DaveScott800/Binary-Clock/Bin Clk Sch_PCB_Combo.JPG

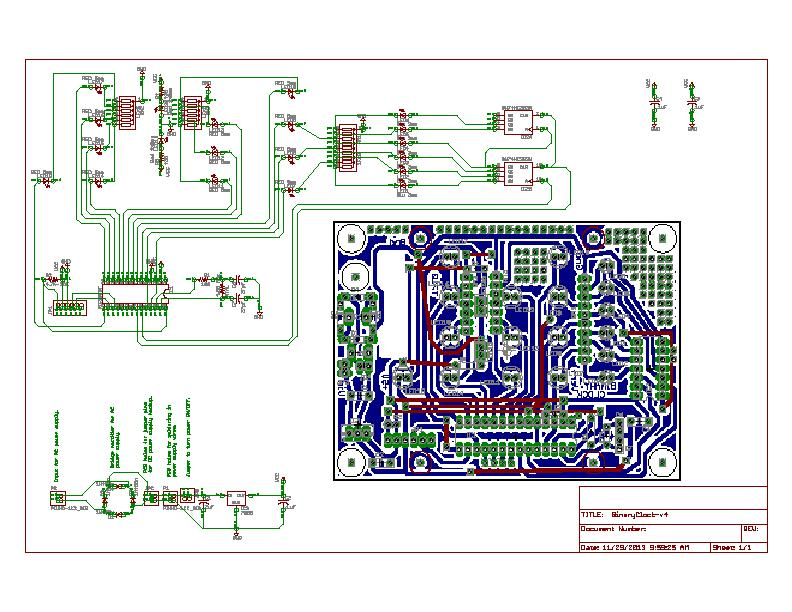
Bin Clk Sch_PCB_Combo.JPG
