DaveScott800/Binary-Clock/README.md

# Binary-Clock
A project for Electronics merit badge to build a binary clock.  The hours and minutes are binary coded decimal.  The seconds are ordinary binary (6 leds).  The seconds LEDs only count up once every 5 minutes.
The circuit uses a PIC16F57 and a SN74HC393N.
