DaveScott800/Binary-Clock/Parts List BOM.xls

PARTS LIST
Part | Qty | Part Number | Description | Identification
C1 | 1 | 493-1057-ND | CAP ALUM 10UF 25V 20% RADIAL | 10uF 25V
C2-C4 | 3 | 490-5401-ND | CAP CER 0.1UF 50V RADIAL | 104Z
C6&C7 | 2 | 445-4719-ND | CAP 27PF CERAMIC 5% COG NPO 50V | 27
IC1 | 1 | PIC16F57-I/SP-ND | IC MCU 8BIT 3KB FLASH 28SDIP | PIC16F57 (Static sensitive - avoid extra handling!)
IC2 | 1 | 296-8319-5-ND | IC DUAL 4-BIT BIN CNTR 14-DIP | SN74HC393N (Static sensitive - avoid extra handling!)
LED19 & 20 | 2 | 754-1201-ND | LED RECT 2X5MM 625NM RED DIFF | Red rectangular LEDs
LED1-LED6 | 6 | 754-1603-ND | LED GREEN DIFF 3MM 568NM | Green 3mm LEDs (Static sensitive - avoid extra handling!)
LED7-LED18 | 12 | 754-1264-ND | LED SS 5MM 625NM RED DIFF | Red 5mm round LEDs
R1,R3 | 1 | 100QBK-ND | RES 100 OHM 1/4W 5% AXIAL | Resistor (brown-black-brown).
R2 | 1 | 5.1KQBK-ND | RES 5.1KOHM 1/4W 5% AXIAL | Resistor (green-brown-red).
R4 & R5 | 2 | 430EBK-ND | RES 430 OHM 1/6W 5% AXIAL | Resistor (yellow-orange-brown).
RN1 | 1 | 4610X-1-102LF-ND | RES ARRAY 1K OHM 9 RES 10SIP | 10X-1-102LF
RN2&RN3 | 2 | 4606X-1-102LF-ND | RES ARRAY 1K OHM 5 RES 6SIP | 6X-1-102LF
XTAL | 1 | CTX896-ND | CRYSTAL 4MHZ 18PF THRU | ATS040B (Physically sensitive - avoid extra handling!)
 | 1 | ED3050-5-ND | CONN IC SOCKET VERT 28POS TIN | 28 pin IC socket.
 | 1 | ED3045-5-ND | CONN IC SOCKET VERT 14POS TIN | 14 pin IC socket.
 | 1 | SR032-CB-ND | BOX 4.38X3.25X1.40 BLACK | Plastic Box.
JP1, JP3 | 8 | S1012EC-36-ND | CONN HEADER .100 SNGL STR 36POS | In Bug Box #6. Cut off a 2-fer and a 6-fer with diagonal cutters.
 | 1 |  | PCB | Binary Clock ver 4
 | 1 |  | Jumper for 2 pins, small black square. | In Bug Box #6.
 | 4 |  | #4 X 1/2" sheet metal screws | In Bug Box #6.
 | 4 |  | Spacers, 0.3" or 5/16" cut from tubing. | See step 14.1.
The Part Numbers are Digikey numbers.
If you mail a check with your written order, Digikey charges nothing for shipping and handling!
So, you can order your parts for the costs of the parts alone plus sales tax!
Note - I've used the part listed above for LED19 & LED20. But in the finished project, they don't show up as visually different from the LED7-18.
This work is licensed for any non-commercial use under the Creative Commons Attribution-NonCommercial-ShareAlike 4.0 International License.
To view a copy of this license, visit http://creativecommons.org/licenses/by-sa/4.0/ or send a letter to Creative Commons, PO Box 1866, Mountain View, CA 94042, USA.
x
