DaveScott800/Binary-Clock/LED Calculations.xls

 |  |  |  | Notes |  |  |  |  |  |  |  |  | Prices
Source | Date | Part# | Desc. | mcd | Vf | ma | Angles | Lens Type |  | R |  |  | ea@1 | ea@10 | ea@25 | ea@50 | ea@100
Digikey | 2013-07-17 | 754-1596 | LED Blue Clear 3mm 470nm | 2000 | 3.3 | 20 | 20 | Clear |  | 1000 | 0.0017 | 2ma OK
Digikey | 2013-09-01 | 754-1603 | LED Green Diff 3mm 568nm | 30 | 2.2 | 10 | 40 | Diffused, Tinted |  | 1000 | 0.0028 | 3-5 ma OK
Digikey | 2013-09-01 | 1080-1012-1 | LED Oval Blue Diff 1A 110X50 | 1085 | 3.2 | 20 | 110,50 | Diffused, Tinted |  | 1000 | 0.0018
Digikey | 2013-09-01 | 365-1173 | LED Blue Round 3mm 470nm | 900 | 3.4 | 20 | 45 | Round, clear |  | 800 | 0.002 | 2 ma ok
Digikey | 2013-09-01 | 754-1264 | LED Red SS 5mm Diff 625nm | 45 | 2 | 10 | 30 | Diffused, Tinted |  | 1000 | 0.003 | 3-5 ma is OK.
Digikey | 2013-07-17 | 754-1201 | LED Red Diff Rect 2X5mm 625nm | 5 | 2 | 10 | 110 | Diffused, Tinted |  | 425 | 0.007058823529 | looks weak below 7 ma
Other LEDs: (11/22/15) |  |  |  |  |  |  |  |  |  | R (Short calc)
Mouser |  | 859-LTL-10223W | Red 5mm 625nm |  |  |  |  |  |  |  |  |  |  | 0.069 |  | 0.061 | 0.055
Mouser |  | 859-LTL-4253 | Yellow 5mm | 19 |  |  |  |  |  | 456 |  |  |  |  |  | 0.061 | 0.055
Mouser |  | 859-LTL-307A | Amber 5mm | 29 |  |  |  |  |  | 696 |  |  |  |  | 0.069 | 0.061 | 0.055
Mouser |  | 859-LTL-4233 | Green 5mm | 19 |  |  |  |  |  | 456 |  |  |  |  | 0.069 | 0.061 | 0.055
Mouser |  | 696-SSL-LX3054GW | Greem 3mm 565nm | 30 |  |  |  |  |  | 720 |  |  | 0.13 |  |  |  | 0.117
Mouser |  | 604-WP132XID | Red 3mm 625nm | 25 |  |  |  |  |  | 600 |  |  |  | 0.092 |  |  | 0.068
Mouser |  | 604-WP132XYD | Yellow 3mm | 25 |  |  |  |  |  | 600 |  |  |  | 0.092 |  |  | 0.068
Mouser |  | 859-LTL-1CHA | Amber 3mm 602nm | 12.6 |  | Same nm as preferred from Digikey |  |  |  | 302.4 |  |  | 0.1 | 0.069 |  | 0.061 | 0.055
Mouser |  | 859-LTL-1CHAE | Amber 3mm 605nm | 29 |  | Might be ok also as dominant nm matches. |  |  |  | 696 |  |  | 0.1 | 0.069 |  | 0.061 | 0.055
 |  | 2015-11-21
 |  |  |  | Vf | Vsup | R | I | MCDnom | MCDact | Short Calc |  | Short Calc = R to get 12.5mcd approximation.
 |  | 754-1603 | Grn 3mm | 1.85 | 5 | 1000 | 3.15 | 25 | 7.9 | 600
 |  |  | Typ 25 mcd @ 10ma and is linear with current (more or less for all these LEDs that I checked). |  |  |  |  |  |  |  |  | MCD nom | Use R
 |  |  | Vf = 2.2 @ 20ma |  |  |  |  |  |  |  |  | 7 | 430
 |  |  | Vf = 2.0 @ 10ma |  |  |  |  |  |  |  |  | 25 | 1000
 |  |  | Vf = 1.8 @ 2ma |  |  |  |  |  |  |  |  | 29 | 700
 |  | 754-1201 | Red 2X5 | 1.82 | 5 | 430 | 7.395348837 | 7 | 5.2 | 168 |  | 50 | 1000
 |  |  | Typ 7 mcd @ 10ma
 |  |  | Vf = 2.0 @ 20ma
 |  |  | Vf = 1.9 @ 10ma
 |  |  | Vf = 1.82 @ 6ma
 |  |  | Vf = 1.7 @ 2ma
 |  | 754-1264 | Red 5mm | 1.75 | 5 | 1000 | 3.25 | 50 | 16.2 | 1200
 |  |  | Typ 50 mcd @ 10ma
 |  |  | Vf = 2.0 @ 20ma
 |  |  | Vf = 1.9 @ 10ma
 |  |  | Vf = 1.82 @ 6ma
 |  |  | Vf = 1.7 @ 2ma
 |  | 160-1949 | Amber 5mm | 1.85 | 5 | 700 | 4.5 | 29 | 13.1 | 696 | With R=1000 is maybe OK, a bit marginal when viewed from an angle.
 |  |  | Typ 29 mcd @ 10ma | 1.75 | 5 | 1000 | 3.25 | 29 | 9.4 | 696
 |  |  | Vf = 2.1 @ 20ma
 |  |  | Vf = 1.85 @ 10ma
 |  |  | Vf = 1.72 @ 5ma
