DaveScott800/Binary-Clock/PCB Image v5.pdf

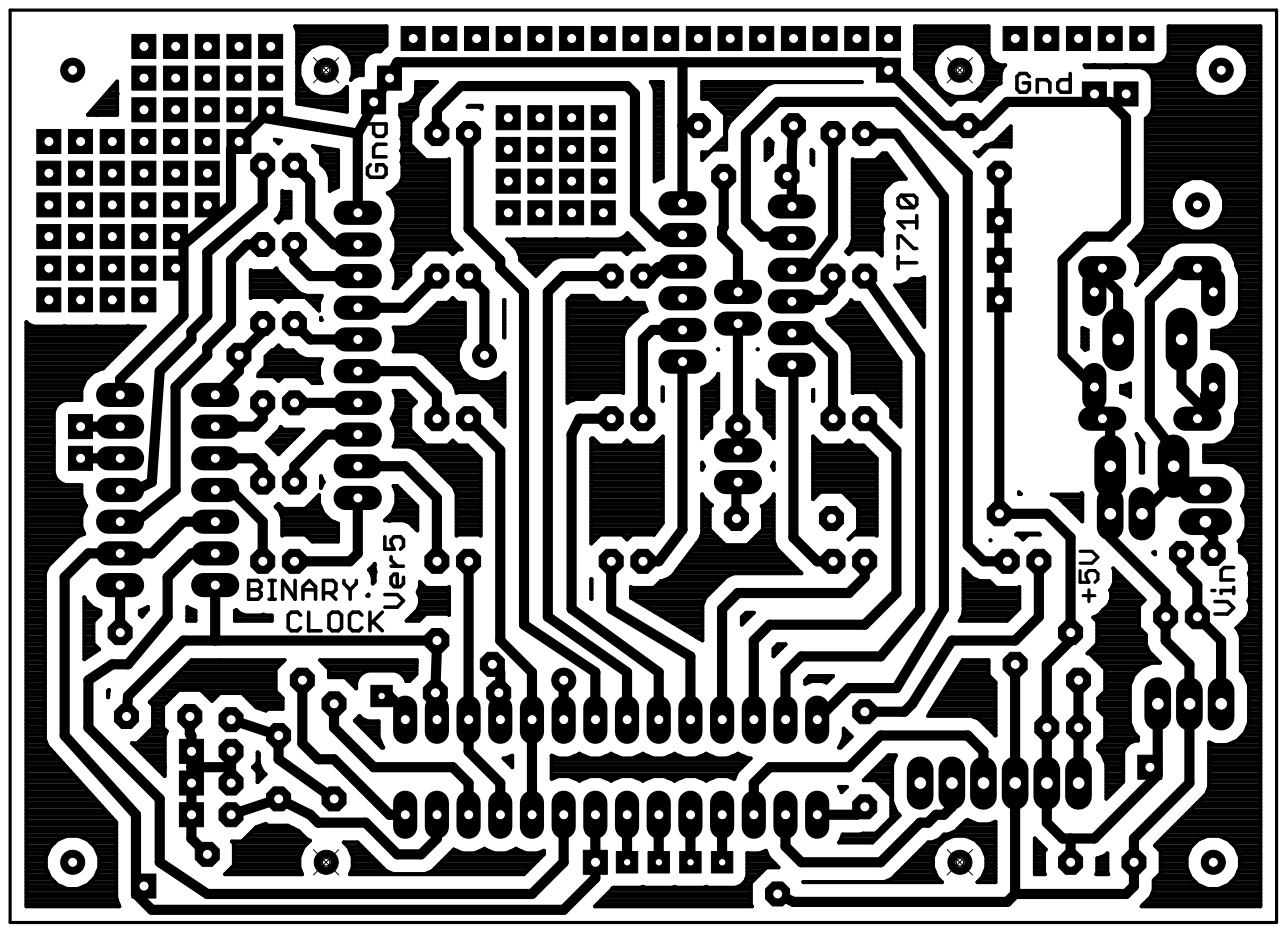
[picture p25: page 1]
