DaveScott800/Binary-Clock/BinaryClock-v5.brd

## EAGLE design BinaryClock-v5.brd (2016-07-04)

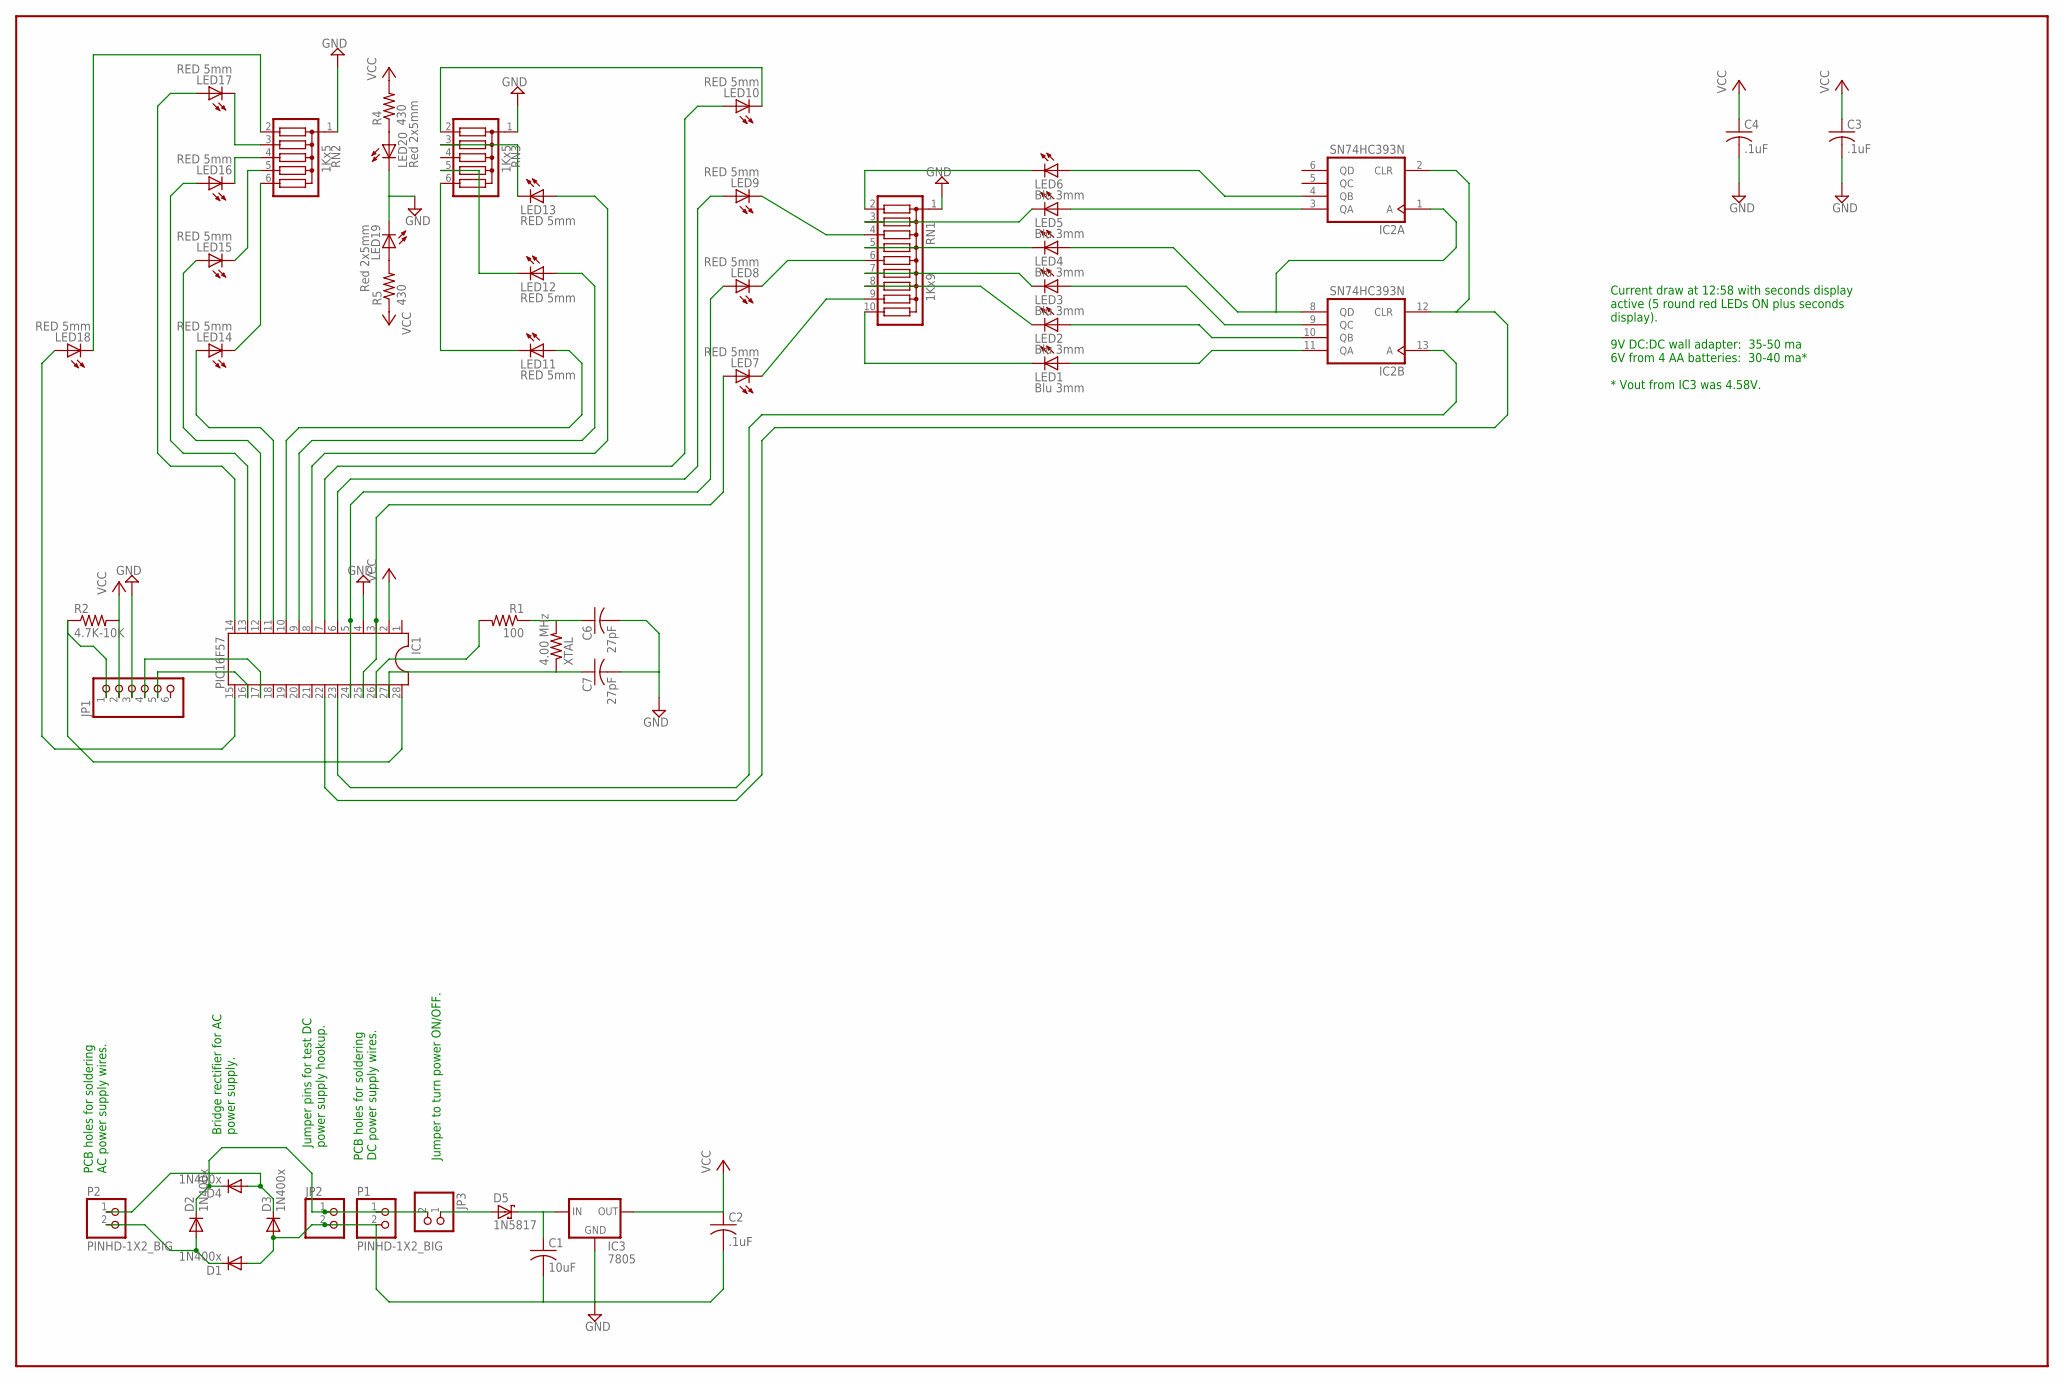
[picture p26: schematic BinaryClock-v5.sch]

Parts:
C1: 10uF; C025-050X050
C2, C3, C4: .1uF; C050-025X075
C6, C7: 27pF; C025-025X050
D1, D2, D3, D4: 1N400x; D-7.5
D5: 1N5817; 0207/2V
IC1: PIC16F57; DIL28-3
IC2: SN74HC393N; DIL14
IC3: 7805; 78MXXS
JP1: PINHD-1X6/90; 1X06/90
JP2, JP3: PINHD-1X2; 1X02
LED1, LED2, LED3, LED4, LED5, LED6: Blu 3mm; LED3MM
LED7, LED8, LED9, LED10, LED11, LED12, LED13, LED14, LED15, LED16, LED17, LED18: RED 5mm; LED5MM
LED19, LED20: Red 2x5mm; U57X32
P1, P2: PINHD-1X2_BIG; 1X02_BIG
R1: 100; 0207/7
R2: 4.7K-10K; 0207/2V
R4: 430; 0204/5
R5: 430; 0204/7
RN1: 1Kx9; SIL10
RN2, RN3: 1Kx5; SIL6
XTAL: 4.00 MHz; 0204/5

Connections:
GND: C1.2, C2.2, C3.2, C4.2, C6.2, C7.2, D1.A, D3.A, IC1.4, IC2.7 (GND), IC3.GND, JP1.3, JP2.2, LED19.K (C), LED20.K (C), P1.2, RN1.1, RN2.1, RN3.1
unnamed: IC2.3 (QA), LED5.A
unnamed: IC2.11 (QA), LED1.A
unnamed: IC2.10 (QB), LED2.A
unnamed: IC2.9 (QC), LED3.A
unnamed: IC2.1 (A), IC2.8 (QD), LED4.A
unnamed: C1.1, D5.2 (C), IC3.IN
unnamed: IC2.4 (QB), LED6.A
unnamed: IC1.22, IC2.2 (CLR), IC2.12 (CLR)
unnamed: C7.1, IC1.27, XTAL.1
unnamed: C6.1, R1.1, XTAL.2
unnamed: LED1.K (C), RN1.10
unnamed: IC1.26, R1.2
unnamed: LED7.K (C), RN1.9
unnamed: IC1.28, JP1.1, R2.1
unnamed: IC1.8, LED13.A
unnamed: IC1.16, JP1.5
unnamed: IC1.23, IC2.13 (A)
unnamed: IC1.3, IC1.25, LED7.A
unnamed: IC1.5, IC1.24, LED8.A
unnamed: IC1.6, LED9.A
unnamed: IC1.7, LED10.A
unnamed: IC1.9, LED12.A
unnamed: IC1.10, LED11.A
unnamed: IC1.11, LED14.A
unnamed: IC1.12, LED15.A
unnamed: IC1.13, LED16.A
unnamed: IC1.14, LED17.A
unnamed: IC1.17, JP1.4
unnamed: LED2.K (C), RN1.8
unnamed: LED4.K (C), RN1.5
unnamed: IC1.15, LED18.A
unnamed: LED9.K (C), RN1.4
unnamed: LED3.K (C), RN1.7
unnamed: LED8.K (C), RN1.6
unnamed: LED5.K (C), RN1.3
unnamed: LED6.K (C), RN1.2
unnamed: LED10.K (C), RN3.2
unnamed: LED13.K (C), RN3.3
unnamed: LED11.K (C), RN3.6
unnamed: LED12.K (C), RN3.5
unnamed: LED14.K (C), RN2.6
unnamed: LED15.K (C), RN2.5
unnamed: LED16.K (C), RN2.4
unnamed: LED17.K (C), RN2.3
unnamed: LED18.K (C), RN2.2
unnamed: D2.C, D4.C, JP2.1, JP3.2, P1.1
unnamed: LED20.A, R4.1
unnamed: LED19.A, R5.2
unnamed: D1.C, D2.A, P2.2
unnamed: D3.C, D4.A, P2.1
unnamed: D5.1 (A), JP3.1
VCC: C2.1, C3.1, C4.1, IC1.2, IC2.14 (VCC), IC3.OUT, JP1.2, R2.2, R4.2, R5.1

Notes on the sheet:
PCB holes for soldering AC power supply wires.
Bridge rectifier for AC power supply.
Jumper pins for test DC power supply hookup.
PCB holes for soldering DC power supply wires.
Jumper to turn power ON/OFF.
Current draw at 12:58 with seconds display active (5 round red LEDs ON plus seconds display). 9V DC:DC wall adapter: 35-50 ma 6V from 4 AA batteries: 30-40 ma* * Vout from IC3 was 4.58V.

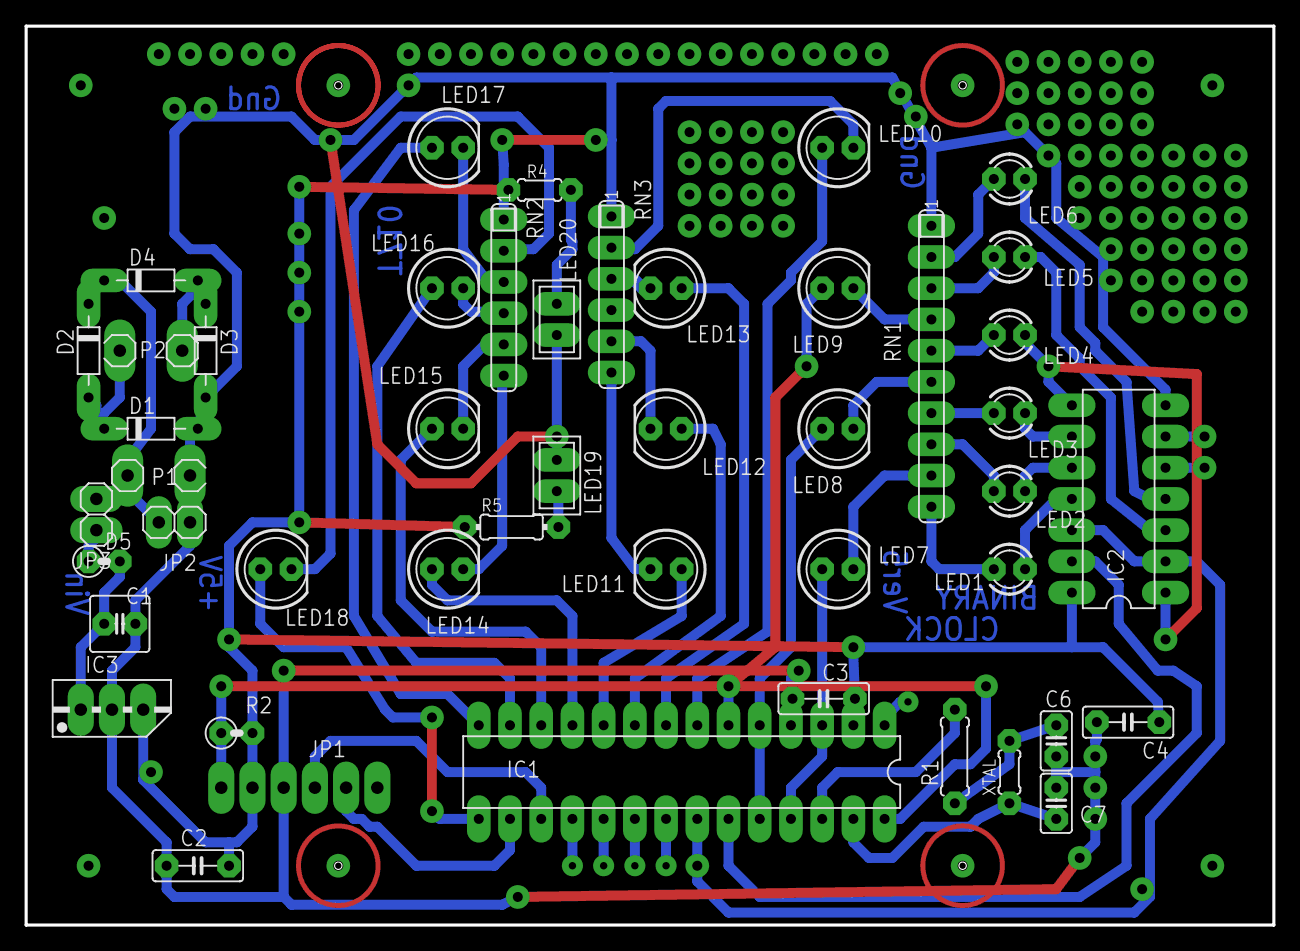
[picture p27: board BinaryClock-v5.brd from above]

Board: 2 copper layers, 101.5 x 73.1 mm, 47 parts (1 on the bottom side), 53 nets.
